OpenGammaProject/Open-Geiger-Counter/hardware/schematic.pdf

# 5V BOOST

# COUNTER

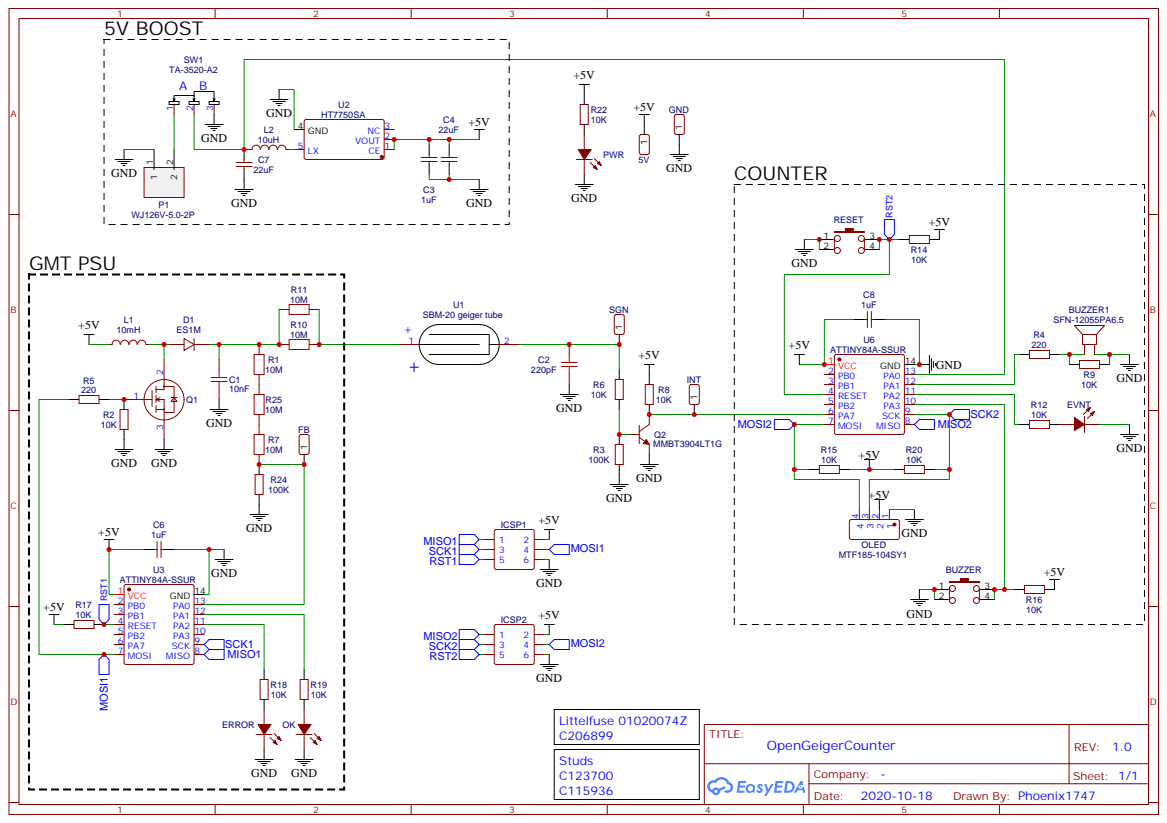
[picture p1: page 1]
