OpenGammaProject/Open-Geiger-Counter/(list of files, drawings)

Other design files:
hardware/pcb_easyeda.json
hardware/schematic_easyeda.json
