OpenGammaProject/Open-Geiger-Counter/(commit log)

2020-10-18 add hardware files
    [pcb_easyeda.json, schematic_easyeda.json]
2020-10-18 add all arduino sketches
